sampidevkit/ACIM-PowerSupply/V0/Production/Picture/Top.png

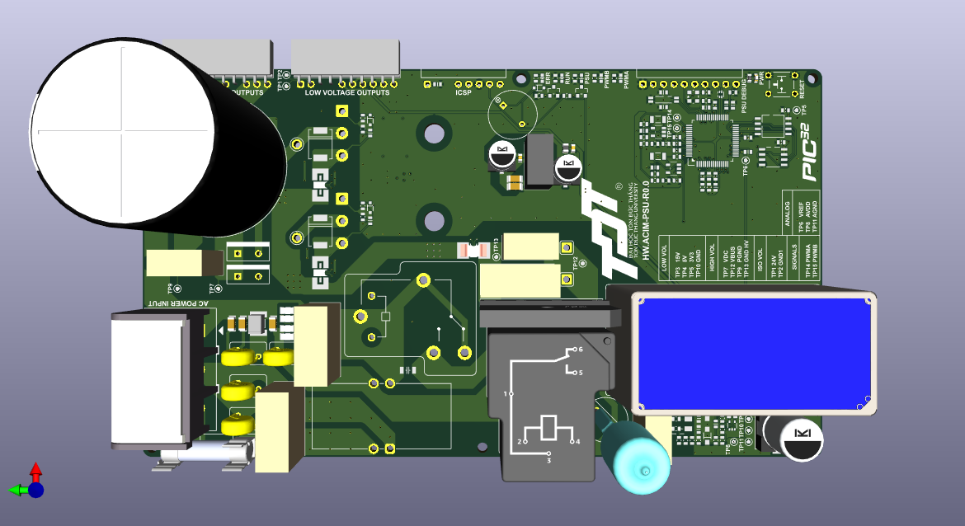
V0/Production/Picture/Top.png
