sampidevkit/ACIM-PowerSupply/Readme.md

# AC INDUCTION MOTOR - POWER SUPPLY BOARD
