sampidevkit/ACIM-PowerSupply/V0/Docs/Ferrite Toroid Coil 1200uH.pdf

– 4 - 5/23/24 9:33 AM
Coil64 v2.2.31 - Ferrite toroid coil

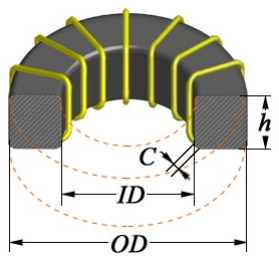
[picture p2: figure]

Input:
Inductance L: 1,200 microH Outside diameter OD: 31.5 mm Inside diameter ID: 18.8 mm Core height h: 13.3 mm
Wire diameter d: 1.5 mm
Magnetic permeability μ: 6,200 Chamfer C: 2 mm

Result:
Number of turns of the coil N = 11.996
Length of wire without leads lw = 47.144 cm
AL = 8,339 nH/N² Effective magnetic path length (le): 75.609 mm

Effective area of magnetic path (Ae): 80.926 mm² Effective volume (Ve): 6,118.72 mm³

1
