sampidevkit/ACIM-PowerSupply/V0/Docs/Ferrite Toroid Coil 900uH.pdf

1 - 12/19/23 10:08 PM

## Coil64 v2.1.29 - Ferrite toroid coil


Input:
Inductance L: 900 microH
Outside diameter OD: 31 mm Inside diameter ID: 19 mm
Core height h: 13 mm
Wire diameter d: 1 mm
Init magnetic permeability μ: 1,000 Chamfer C: 0 mm

Result:
Number of turns of the coil N = 26.591 Length of wire without leads lw = 1.01 m AL = 1,273 nH/N²

1
