sampidevkit/ACIM-PowerSupply/V0/Docs/WireDiaCalc.png

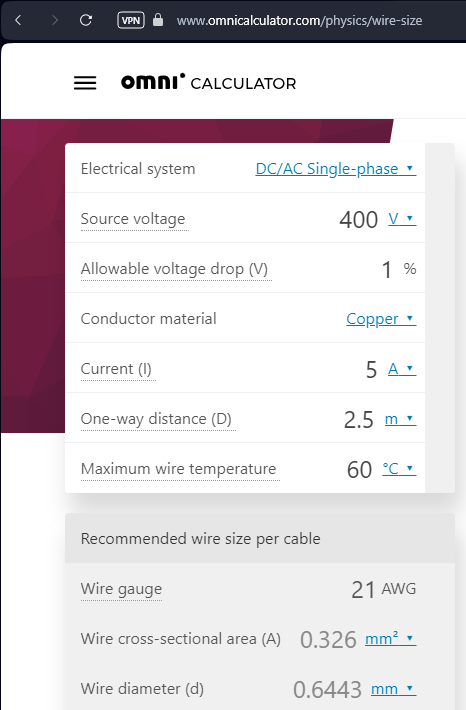
V0/Docs/WireDiaCalc.png
