sampidevkit/ACIM-PowerSupply/V0/Production/Picture/Bot 2.png

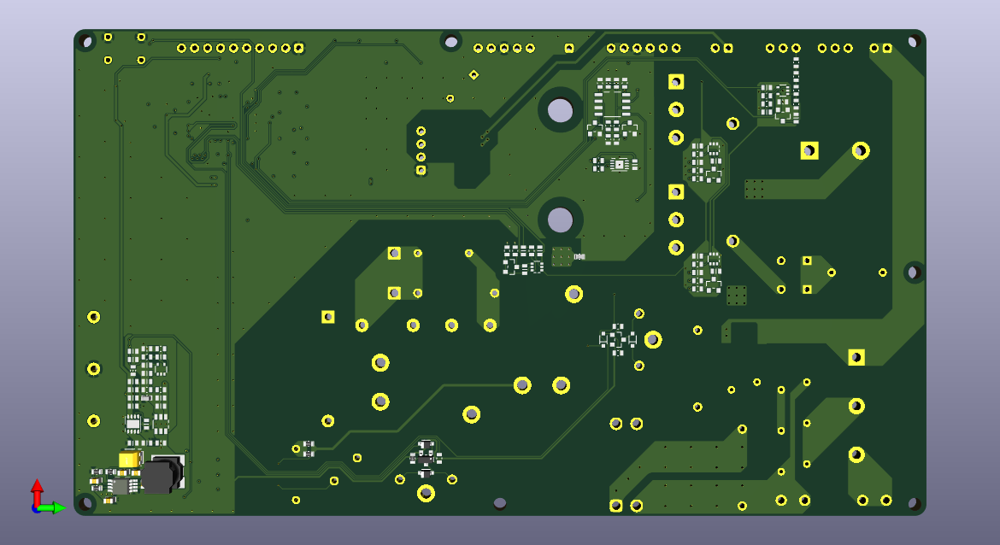
V0/Production/Picture/Bot 2.png
