sampidevkit/ACIM-PowerSupply/V0/Production/Picture/Top 2.png

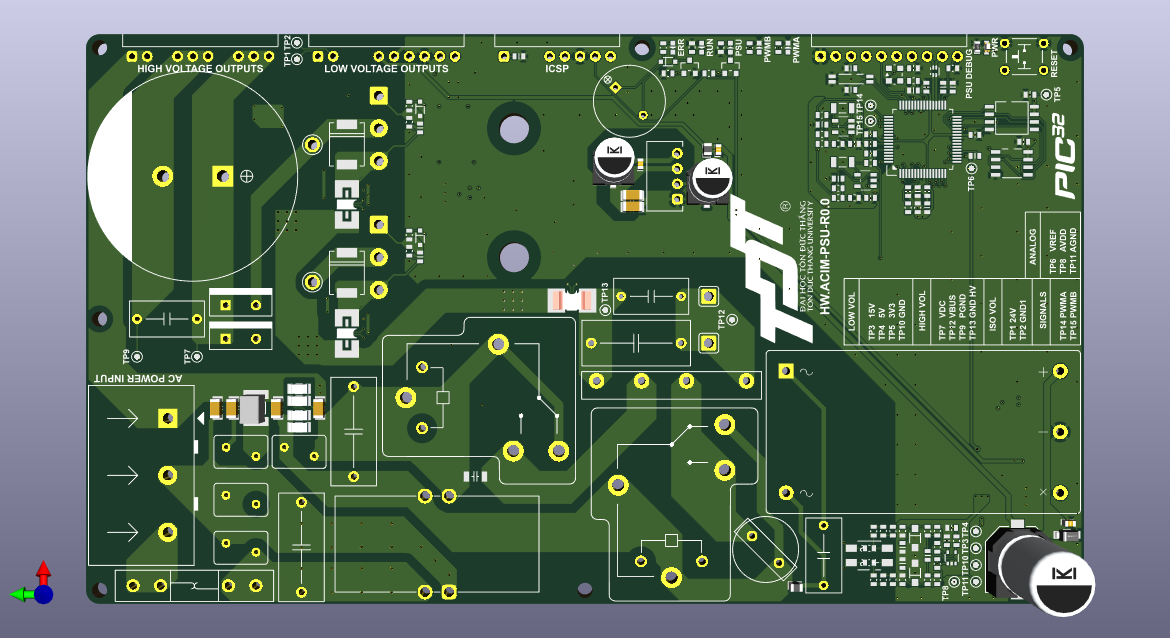
V0/Production/Picture/Top 2.png
