sampidevkit/ACIM-PowerSupply/V0/Production/BoM/HW.ACIM-PSU.xlsx

# | MNP | MFT | Description | Reference | Qty
35 | YK4410303000G | Amphenol | CONN BARRIER STRIP 3CIRC 0.374" | J1 | 1
25 | MMBD4148SE | ANBON | DIODE ARRAY GP 75V 150MA SOT23 | D12,D13,D16,D17 | 4
40 | MOV-07D471KTR | Bourns | VARISTOR 470V 1.2KA DISC 7MM | M1,M2,M3,M4 | 4
17 | ESMQ451VSN681MA50S | Chemi-Con | CAP ALUM 680UF 20% 450V SNAP | C44 | 1
4 | TS02-66-170-BK-160-SCR-D | CUI | SWITCH TACTILE 6x6x17MM SPST-NO 0.05A 12V | BT1 | 1
43 | DMN2310U-7 | Diodes | MOSFET N-CH 20 V 1.6A SOT-23-3 | Q1,Q2,Q4,Q5,Q8 | 5
64 | ZXCT199QA1DW-7 | Diodes | CM VOLTAGE OUTPUT SOT363 T&R 3K | U7,U8,U10 | 3
65 | AP331AWG-7 | Diodes | IC COMPARATOR 1 GEN PUR SOT25 | U12,U13 | 2
23 | S5M | Diotec | DIODE GEN PURP 1KV 5A SMC | D7,D10 | 2
38 | MCL2012V1-4R7-R | Eaton | FIXED IND 4.7UH 120MA 400MOHM SM | L1,L2 | 2
50 | MSMA2512R0050FGM | Eaton | RES 0.005 OHM 1% 3W 2512 | R15,R28 | 2
51 | MSMA2512R0100FGN | Eaton | RES 0.01 OHM 1% 3W 2512 | R19 | 1
21 | F4TVS16A | Good-Ark | TVS, UNI-DIR, 400W, 16V, ESGA | D1 | 1
27 | B19Y1NB--20C000113U1930 | Harvatek | LED BLUE CLEAR 0603 SMD | D18,D24 | 2
28 | B1911USD-20D000114U1930 | Harvatek | LED RED DIFFUSED 0603 SMD | D20 | 1
29 | B1911NG--20D000214U1930 | Harvatek | LED GREEN DIFFUSED 0603 SMD | D21 | 1
30 | B1931TW--20P000314U1930 | Harvatek | LED WHITE 0603 SMD | D22,D23 | 2
33 | MCM1012B121F06BPDG | INPAQ | CMF 1210 120OHM 300MA 2LN SMD | FT5 | 1
13 | TLJB227M006R0500 | KAVX | CAP TANT 220UF 20% 6.3V 1411 | C19 | 1
10 | A768MS477M1ELAE017 | KEMET | CAP ALUM POLY 470UF 20% 25V SMD | C6 | 1
12 | A768EB476M1VLAE042 | KEMET | CAP ALUM POLY 47UF 20% 35V SMD | C10,C18 | 2
31 | 01000056Z | Littelfuse | FUSE CLIP CARTRIDGE 250V 10A PCB | F1 | 1
22 | 1N4148WX-TP | MCC | DIODE GEN PURP 75V 150MA SOD323 | D2,D3,D4,D5,D6,D9,D19 | 7
26 | BZT52C3V0-TP | MCC | DIODE ZENER 3V 200MW SOD123 | D14,D15 | 2
24 | APT15DQ60KG | Microchip | DIODE GP 600V 15A TO220 | D8,D11 | 2
58 | MCP16311-E/MS | Microchip | IC REG BUCK ADJ 1A 8MSOP | U1 | 1
59 | MCP1727-3302E/MF | Microchip | IC REG LINEAR 3.3V 1.5A 8DFN | U2 | 1
60 | MCP1501T-33E/CHY | Microchip | IC VREF SERIES 0.1% SOT23-6 | U3 | 1
61 | AT30TS74-MA8M-T | Microchip | SENSOR DIGITAL -55C-125C 8UDFN | U4 | 1
62 | MCP14E4T-E/SN | Microchip | IC GATE DRVR LOW-SIDE 8SOIC | U5 | 1
66 | PIC32MK1024MCM064-I/PT | Microchip | IC MCU 32BIT 1MB FLASH 64TQFP | U14 | 1
69 | DSC1001CE1-012.0000 | Microchip | MEMS OSC XO 12.0000MHZ CMOS SMD | U17 | 1
41 | LD10-23B15R2-RC | Mornsun | ENCLOSED AC DC CONVERTER 10W 1 O | MD1 | 1
42 | B1524S-1WR3 | Mornsun | DC DC CONVERTER 24V 1W | MD2 | 1
63 | NCV21871SQ3T2G | Onsemi | IC OPAMP GP 1 CIRCUIT SC88A | U6,U9,U11 | 3
7 | ECW-FE2W105K | Panasonic | CAP FILM 1UF 10% 450VDC RADIAL | C2,C11,C35 | 3
5 | AT-1224-TWT-5V-2-R | PUI | BUZZER MAGNETIC 5V 12MM TH | BZ1 | 1
32 | PE-0603PFB121ST | Pulse | FERRITE BEAD 120 OHM 1A 0603 1LN | FT2,FT3,FT4,FT6 | 4
9 | CL10B104KB8NNNC | Samsung | CAP CER 0.1UF 50V X7R 0603 | C4,C9,C13,C16,C17,C20,C23,C24,C25,C26,C37,C38,C41,C46,C49,C50,C51,C59,C62,C64,C65,C66,C67,C68,C69,C71,C76,C77,C78,C79,C80,C82,C83,C90 | 34
11 | CL10A106MQ8NNNC | Samsung | CAP CER 10UF 6.3V X5R 0603 | C8,C27,C29,C34,C42,C85 | 6
15 | CL10B332KB8NNNC | Samsung | CAP CER 3.3nF 50V X7R 0603 | C30,C32,C53,C54 | 4
16 | CL10B102KB8NNNC | Samsung | CAP CER 1nF 50V X7R 0603 | C36,C40,C47,C48,C52,C57,C58,C60,C61,C63,C70,C72,C73 | 13
18 | CL10A105KA8NNNC | Samsung | CAP CER 1UF 25V X5R 0603 | C55 | 1
19 | CL10B103KB8NNNC | Samsung | CAP CER 10nF 50V X7R 0603 | C56 | 1
2 | GBJ2510 | SMC | BRIDGE RECT 1PHASE 1KV 25A GBJ | BR1 | 1
3 | MB10F | SMC | BRIDGE RECT 1PHASE 1KV 500MA MBF | BR2 | 1
57 | SLA-5VDC-SL-C | Songle | 5V 30A SPDT (1 Form C) 6 Plugin,27.6x32mm Power Relays ROHS | RL1,RL2 | 2
44 | STGWT40HP65FB | ST | TRENCH GATE FIELD-STOP IGBT, HB | Q3,Q6 | 2
67 | M95256-WMN6P | ST | IC EEPROM 256KBIT SPI 8SOIC | U15 | 1
36 | PPTC101LGBN-RC | Sullins | CONN HDR 10POS 0.1 TIN PCB R/A | J2,J4,J5 | 3
37 | PBC08SBAN | Sullins | CONN HEADER R/A 8POS 2.54MM | J3 | 1
39 | HPC 6045NV-220M | TAI-TECH | FIXED IND 22UH 1.9A 0.096OHM SMD | L3 | 1
6 | BFC233824104 | VISHAY | CAP FILM 0.1UF 20% 560VDC RADIAL | C1,C28,C43 | 3
45 | SI2301CDS-T1-GE3 | Vishay | MOSFET P-CH 20V 3.1A SOT23-3 | Q7 | 1
14 | 0603N220J500CT | Walsin | CAP CER 22PF 50V C0G/NP0 0603 | C22,C31,C33,C45,C75,C81,C84,C86,C87 | 9
48 | WR12X105 JTL | Walsin | RES 1M OHM 5% 1/4W 1206 | R4,R7,R8,R9,R69,R70 | 6
8 | 885342208022 | WE | CAP CER 100PF 2000V X7R 1206 | C3,C5,C7,C12,C14,C15,C21 | 7
68 | W25Q128FVSG | Winbond | IC FLASH 128MBIT SPI/QUAD 8SOIC | U16 | 1
20 | CC0603BRNPO9BN9R0 | YAGEO | CAP CER 9PF 50V C0G/NPO 0603 | C88,C89 | 2
34 | 4532-301-LF | YAGEO | GDT SMD 4532, 300V30% 2KA, REEL | G1 | 1
46 | RC0603FR-0710RL | YAGEO | RES 10 OHM 1% 1/10W 0603 | R1,R2,R17,R25,R33,R34,R35,R36,R45,R47,R48,R55,R56,R57,R58,R71,R72,R73 | 18
47 | RC0603FR-07100KL | YAGEO | RES 100K OHM 1% 1/10W 0603 | R3,R5,R11,R13,R20,R22,R29,R30,R37,R38,R39,R40,R41,R42,R61,R62,R63,R64,R65,R75,R79,R82 | 22
49 | RC0603FR-0710KL | YAGEO | RES 10K OHM 1% 1/10W 0603 | R6,R10,R12,R14,R16,R18,R24,R26,R27,R59,R76 | 11
52 | AC0603FR-071K1L | YAGEO | RES SMD 1.1K OHM 1% 1/10W 0603 | R21,R23,R43,R44,R46,R49,R50,R66,R67,R68,R74,R77,R78,R80,R81,R84,R85 | 17
53 | RC0603FR-0739K2L | YAGEO | RES 39.2K OHM 1% 1/10W 0603 | R51,R52 | 2
54 | RC0603FR-1340K2L | YAGEO | RES 40.2K OHM 1% 1/10W 0603 | R53,R54 | 2
55 | RC0603FR-13470KL | YAGEO | RES 470K OHM 1% 1/10W 0603 | R60 | 1
56 | RC0603JR-070RL | YAGEO | RES 0 OHM JUMPER 1/10W 0603 | R83 | 1
70 | 32.768K12.5PI/6914E | YIC | CRYSTAL 32.7680KHZ 12.5PF SMD | X1 | 1
1 | 1609954437_VNAMZ-6936739394 |  | HALOGEN LAMP 220V/50W | B1 | 1
