sampidevkit/ACIM-PowerSupply/V0/Production/Schematic/HW.ACIM-PSU.pdf

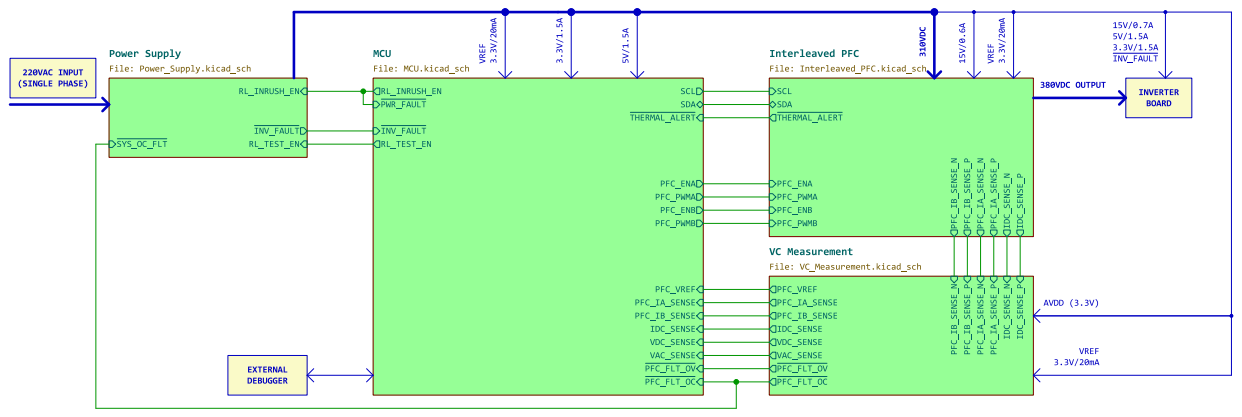
[picture p6: page 1]

Schematic Designed by ... PCB Designed by ... Approved by ...

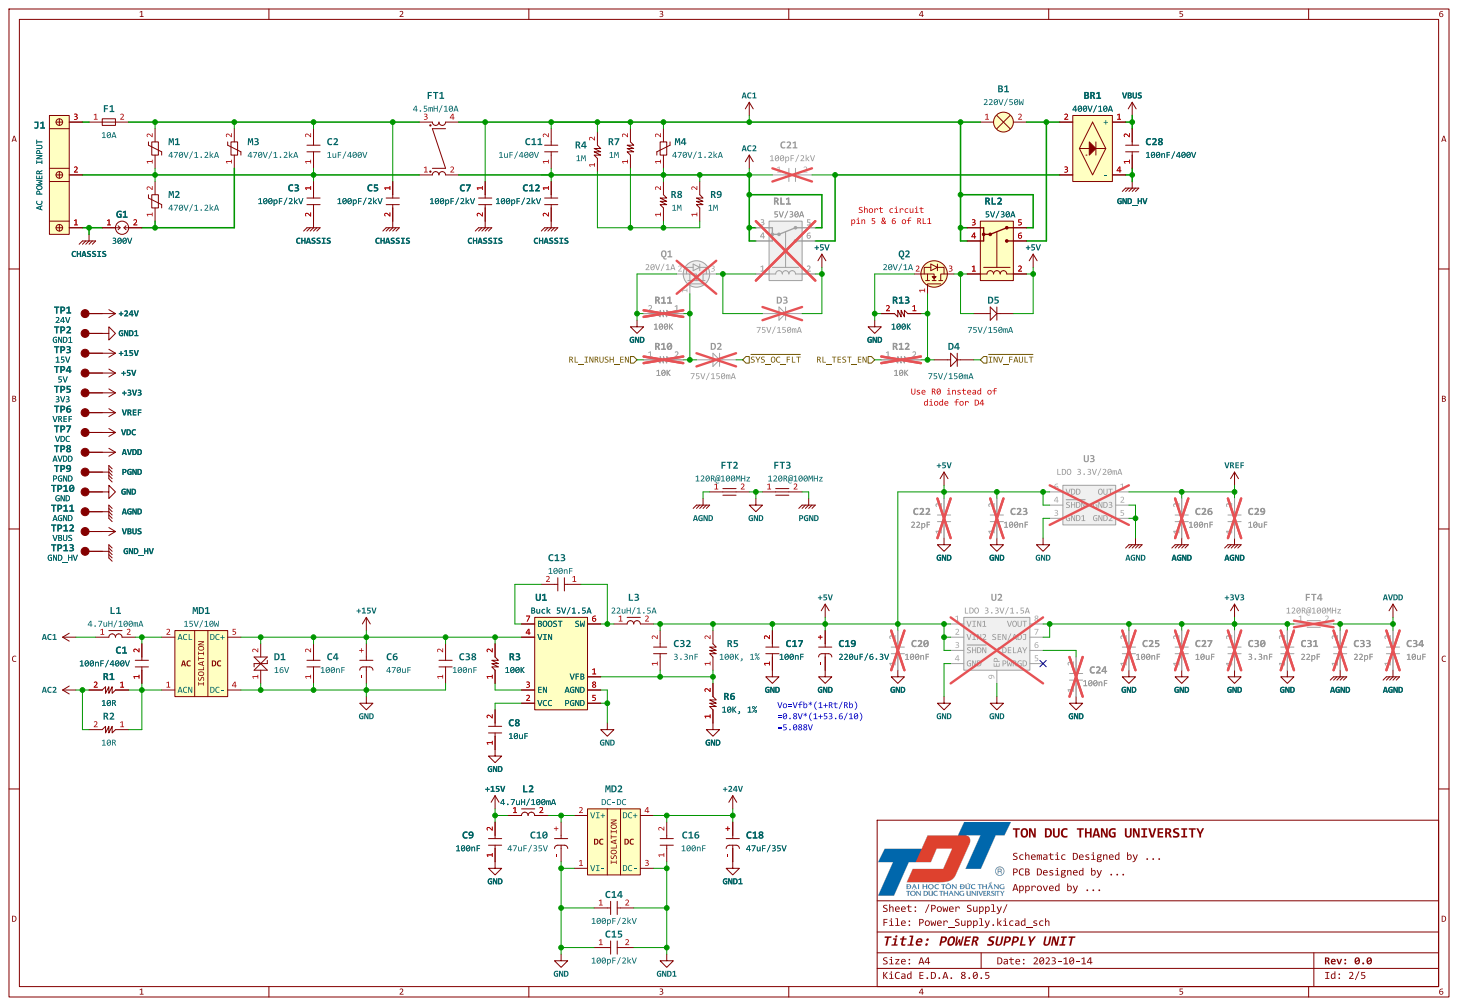
[picture p7: page 2]

Schematic Designed by ... PCB Designed by ... Approved by ... GND

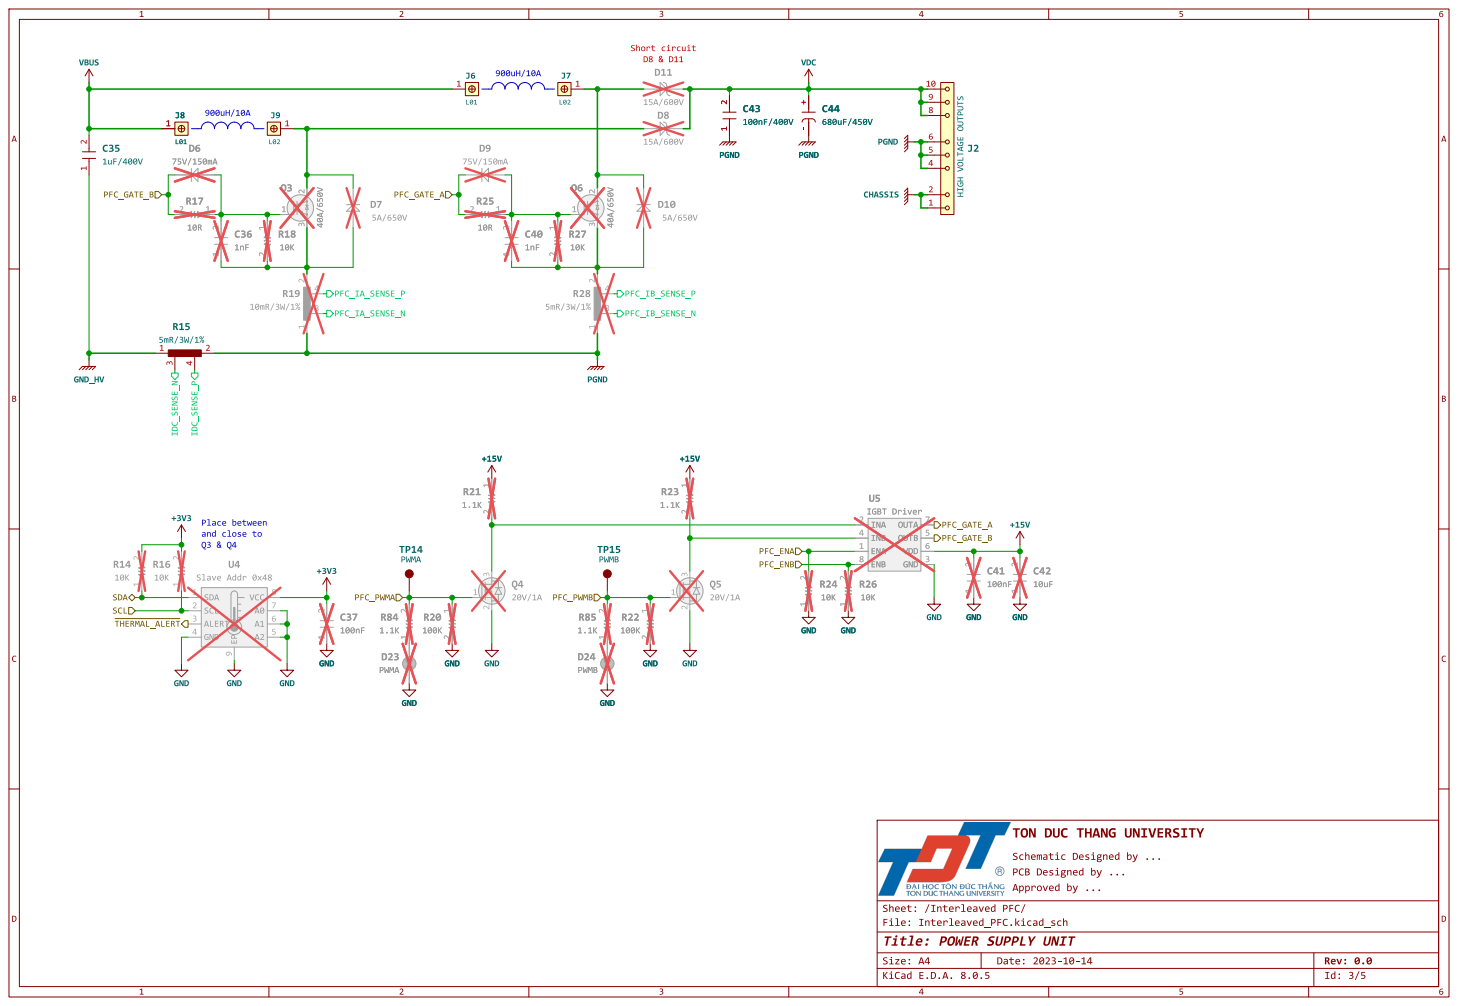
[picture p8: page 3]

1 2 GND GND D24 PWMB GND GNDR20

Schematic Designed by ... PCB Designed by ... Approved by ... D23 PWMA

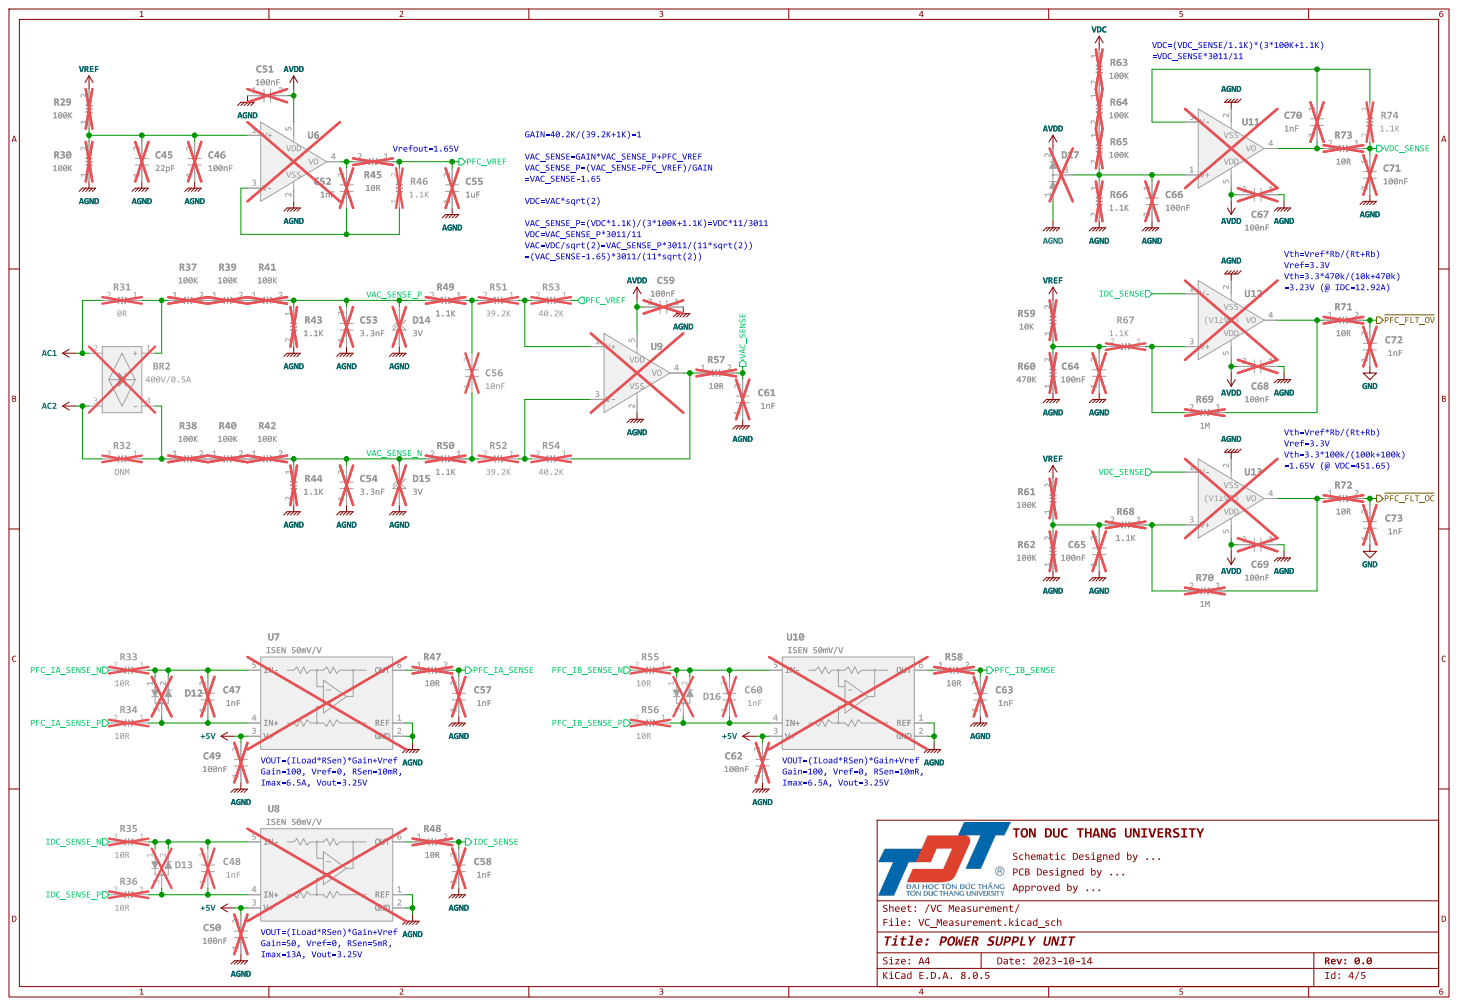
[picture p9: page 4]

VAC_SENSE_P=(VDC*1.1K)/(3*100K+1.1K)=VDC*11/3011 VDC=VAC_SENSE_P*3011/11 VAC=VDC/sqrt(2)=VAC_SENSE_P*3011/(11*sqrt(2))

Vth=Vref*Rb/(Rt+Rb) Vref=3.3V

Schematic Designed by ... PCB Designed by ... Approved by ... AGND

VOUT=(ILoad*RSen)*Gain+Vref Gain=100, Vref=0, RSen=10mR,

VOUT=(ILoad*RSen)*Gain+Vref Gain=50, Vref=0, RSen=5mR,

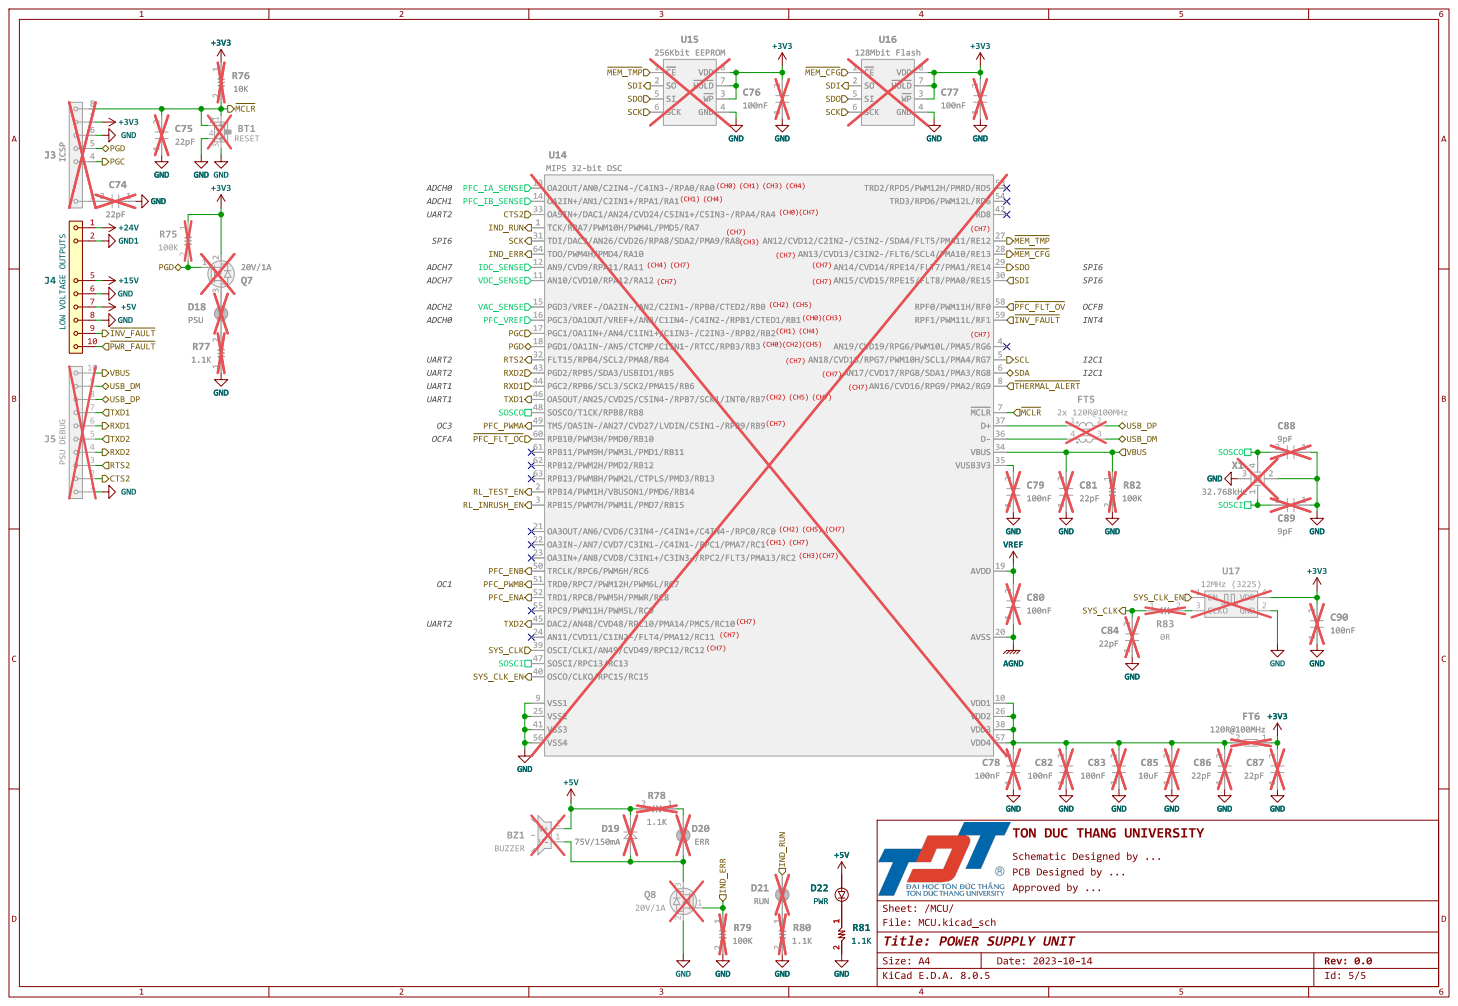
[picture p10: page 5]

Schematic Designed by ... PCB Designed by ... Approved by ...
