sampidevkit/ACIM-PowerSupply/V0/Design/HW.ACIM-PSU/Interleaved_PFC.kicad_sch

## KiCad design V0/Design/HW.ACIM-PSU/Interleaved_PFC.kicad_sch (2024-10-10)

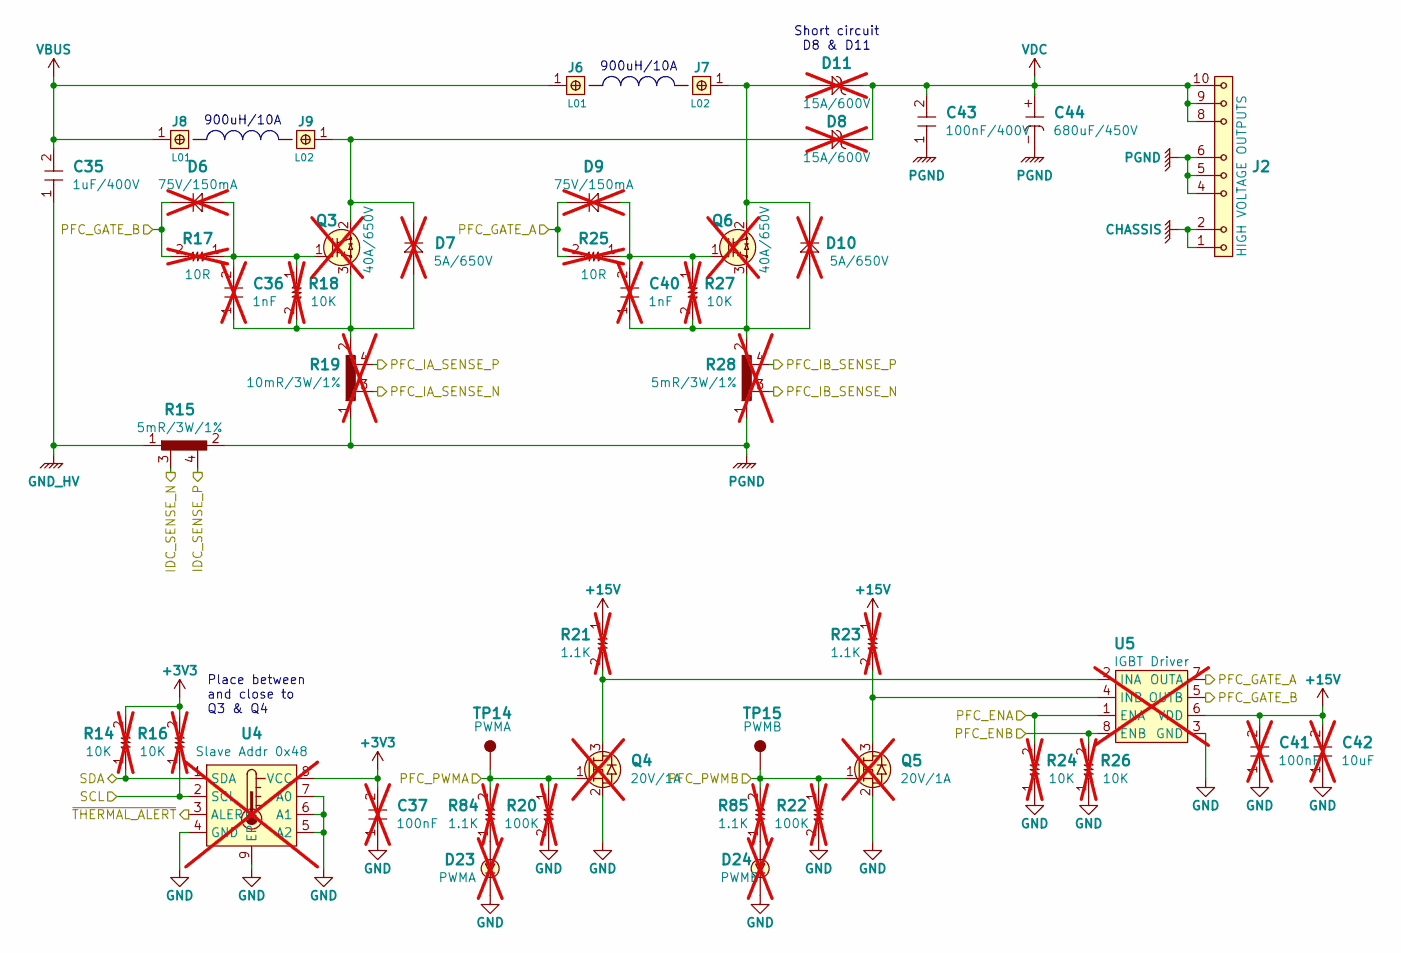
[picture p11: schematic Interleaved_PFC.kicad_sch]

Parts:
C35: 1uF/400V; ECWFE2W105
C36, C40: 1nF; CAP0603; not fitted
C37, C41: 100nF; CAP0603; not fitted
C42: 10uF; CAP0603; not fitted
C43: 100nF/400V; CAP_FILM_6.0x12.0x12.5-P10
C44: 680uF/450V; ESMQ451VSN681MA50S
D6, D9: 75V/150mA; SOD-323; not fitted
D7, D10: 5A/650V; DO-214AB; not fitted
D8, D11: 15A/600V; TO-220; not fitted
D23: PWMA; LED0603; not fitted
D24: PWMB; LED0603; not fitted
J2: HIGH VOLTAGE OUTPUTS; HDF1x10x2.54_TH_RA
J6, J8: L01; PAD01-2516
J7, J9: L02; PAD01-2516
Q3, Q6: 40A/650V; TO-218AC-HF; not fitted
Q4, Q5: 20V/1A; SOT23; not fitted
R14, R16, R18, R24, R26, R27: 10K; RES0603; not fitted
R15: 5mR/3W/1%; SHU2512
R17, R25: 10R; RES0603; not fitted
R19: 10mR/3W/1%; SHU2512; not fitted
R20, R22: 100K; RES0603; not fitted
R21, R23, R84, R85: 1.1K; RES0603; not fitted
R28: 5mR/3W/1%; SHU2512; not fitted
TP14: PWMA; TP1MM
TP15: PWMB; TP1MM
U4: Slave Addr 0x48; TDFN8_2x3_MCHP; not fitted
U5: IGBT Driver; SOIC8_3.9_MCHP; not fitted

Connections:
+3V3: C37.2, R14.2, R16.2, U4.8 (VCC)
+15V: C41.2, C42.2, R21.1, R23.1, U5.6 (VDD)
CHASSIS: J2.1, J2.2
GND: C37.1, C41.1, C42.1, D23.K, D24.K, Q4.2 (S), Q5.2 (S), R20.2, R22.2, R24.1, R26.1, U4.4 (GND), U4.5 (A2), U4.6 (A1), U4.7 (A0), U4.9 (EP), U5.3 (GND)
GND_HV: C35.1, R15.1
IDC_SENSE_N: R15.3
IDC_SENSE_P: R15.4
unnamed: C36.1, D7.A, Q3.3 (S), R18.2, R19.2
unnamed: C36.2, D6.A, Q3.1 (G), R17.1, R18.1
unnamed: C40.1, D10.A, Q6.3 (S), R27.2, R28.2
unnamed: C40.2, D9.A, Q6.1 (G), R25.1, R27.1
unnamed: D7.K, D8.A, J9.1, Q3.2 (D)
unnamed: D10.K, D11.A, J7.1, Q6.2 (D)
unnamed: D23.A, R84.1
unnamed: D24.A, R85.1
unnamed: Q4.3 (D), R21.2, U5.2 (INA)
unnamed: Q5.3 (D), R23.2, U5.4 (INB)
PFC_ENA: R24.2, U5.1 (ENA)
PFC_ENB: R26.2, U5.8 (ENB)
PFC_GATE_A: D9.K, R25.2, U5.7 (OUTA)
PFC_GATE_B: D6.K, R17.2, U5.5 (OUTB)
PFC_IA_SENSE_N: R19.3
PFC_IA_SENSE_P: R19.4
PFC_IB_SENSE_N: R28.3
PFC_IB_SENSE_P: R28.4
PFC_PWMA: Q4.1 (G), R20.1, R84.2, TP14.1
PFC_PWMB: Q5.1 (G), R22.1, R85.2, TP15.1
PGND: C43.1, C44.-, J2.4, J2.5, J2.6, R15.2, R19.1, R28.1
SCL: R16.1, U4.2 (SCL)
SDA: R14.1, U4.1 (SDA)
VBUS: C35.2, J6.1, J8.1
VDC: C43.2, C44.+, D8.K, D11.K, J2.8, J2.9, J2.10
~THERMAL_ALERT: U4.3 (ALERT)

Notes on the sheet:
Short circuit D8 & D11
Place between and close to Q3 & Q4
900uH/10A
