sampidevkit/ACIM-PowerSupply/V0/Design/HW.ACIM-PSU/MCU.kicad_sch

## KiCad design V0/Design/HW.ACIM-PSU/MCU.kicad_sch (2024-10-10)

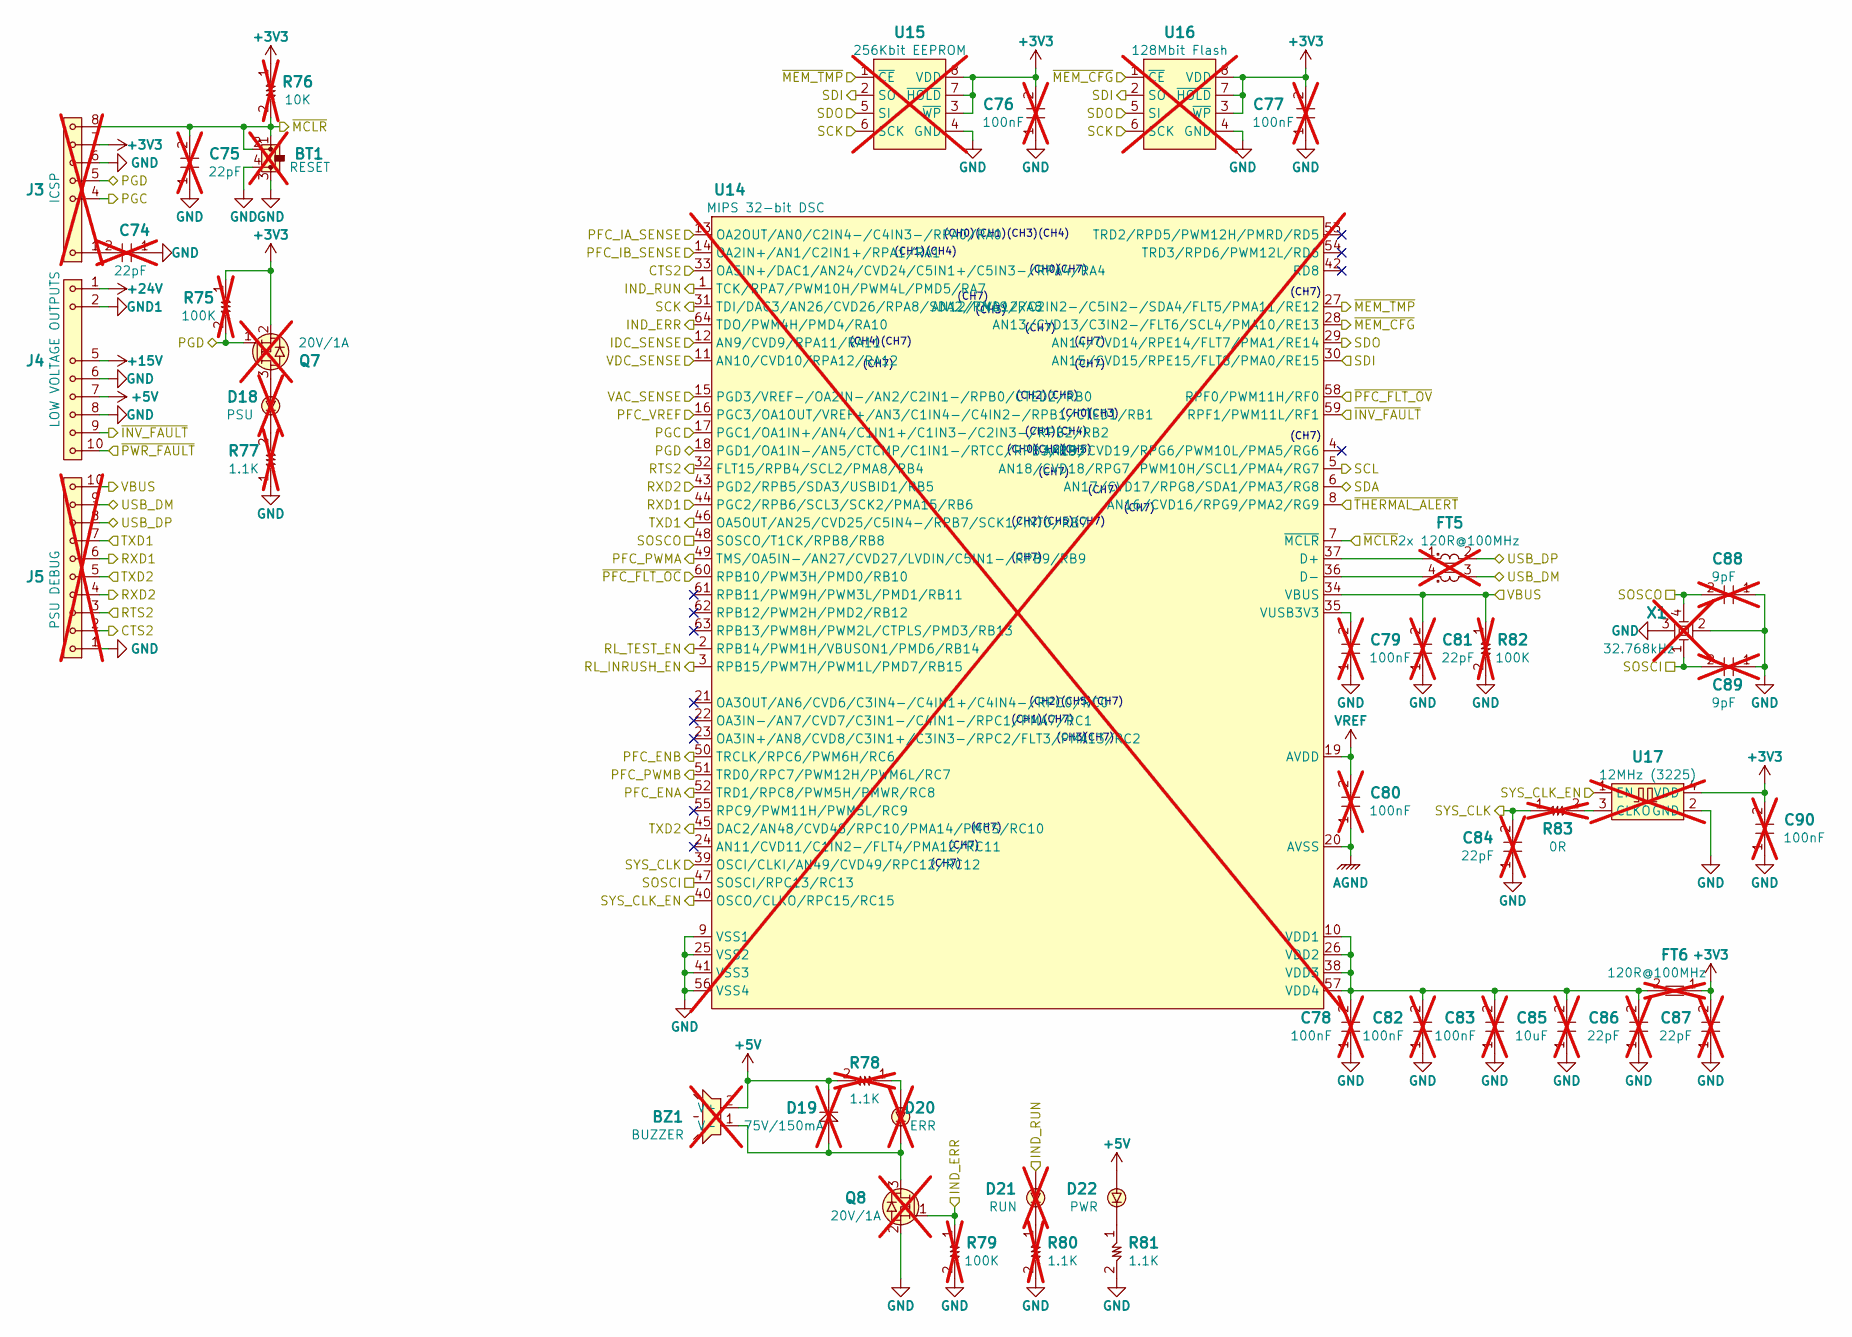
[picture p12: schematic MCU.kicad_sch]

Parts:
BT1: RESET; BUTTON_4P_6x6; not fitted
BZ1: BUZZER; AT-1224; not fitted
C74, C75, C81, C84, C86, C87: 22pF; CAP0603; not fitted
C76, C77, C78, C79, C80, C82, C83, C90: 100nF; CAP0603; not fitted
C85: 10uF; CAP0603; not fitted
C88, C89: 9pF; CAP0603; not fitted
D18: PSU; LED0603; not fitted
D19: 75V/150mA; SOD-323; not fitted
D20: ERR; LED0603; not fitted
D21: RUN; LED0603; not fitted
D22: PWR; LED0603
FT5: 2x 120R@100MHz; IND1210_4P; not fitted
FT6: 120R@100MHz; FT0603; not fitted
J3: ICSP; HDM1x8x2.54_TH_RA; not fitted
J4: LOW VOLTAGE OUTPUTS; HDF1x10x2.54_TH_RA
J5: PSU DEBUG; HDM1x10x2.54_TH_RA; not fitted
Q7, Q8: 20V/1A; SOT23; not fitted
R75, R79, R82: 100K; RES0603; not fitted
R76: 10K; RES0603; not fitted
R77, R78, R80: 1.1K; RES0603; not fitted
R81: 1.1K; RES0603
R83: 0R; RES0603; not fitted
U14: MIPS 32-bit DSC; TQFP64_10x10_MCHP; not fitted
U15: 256Kbit EEPROM; SOIC8_3.9_MCHP; not fitted
U16: 128Mbit Flash; SO8W_5.3; not fitted
U17: 12MHz (3225); CDFN3225-4LD-PL-1; not fitted
X1: 32.768kHz; SMD4-7015; not fitted

Connections:
+3V3: C76.2, C77.2, C87.2, C90.2, FT6.1, J3.7, Q7.2 (S), R75.1, R76.1, U15.3 (~WP), U15.7 (~HOLD), U15.8 (VDD), U16.3 (~WP), U16.7 (~HOLD), U16.8 (VDD), U17.4 (VDD)
+5V: BZ1.2 (V+), D19.K, D22.A, J4.7, R78.2
+15V: J4.5
+24V: J4.1
AGND: C80.1, U14.20 (AVSS)
CTS2: J5.2, U14.33 (OA5IN+/DAC1/AN24/CVD24/C5IN1+/C5IN3-/RP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)
GND: BT1.3, BT1.4, C74.1, C75.1, C76.1, C77.1, C78.1, C79.1, C81.1, C82.1, C83.1, C84.1, C85.1, C86.1, C87.1, C88.1, C89.1, C90.1, J3.6, J4.6, J4.8, J5.1, Q8.2 (S), R77.1, R79.2, R80.2, R81.2, R82.2, U14.9 (VSS1), U14.25 (VSS2), U14.41 (VSS3), U14.56 (VSS4), U15.4 (GND), U16.4 (GND), U17.2 (GND), X1.2 (GND1), X1.3 (GND2)
GND1: J4.2
IDC_SENSE: U14.12 (AN9/CVD9/RPA11/RA11)
IND_ERR: Q8.1 (G), R79.1, U14.64 (TDO/PWM4H/PMD4/RA10)
IND_RUN: D21.A, U14.1 (TCK/RPA7/PWM10H/PWM4L/PMD5/RA7)
unnamed: BZ1.1 (V-), D19.A, D20.K, Q8.3 (D)
unnamed: C74.2, J3.1
unnamed: C78.2, C82.2, C83.2, C85.2, C86.2, FT6.2, U14.10 (VDD1), U14.26 (VDD2), U14.38 (VDD3), U14.57 (VDD4)
unnamed: C79.2, U14.35 (VUSB3V3)
unnamed: D18.A, Q7.3 (D)
unnamed: D18.K, R77.2
unnamed: D20.A, R78.1
unnamed: D21.K, R80.1
unnamed: D22.K, R81.1
unnamed: FT5.1, U14.37 (D+)
unnamed: FT5.4, U14.36 (D-)
unnamed: R83.2, U17.3 (CLKO)
PFC_ENA: U14.52 (TRD1/RPC8/PWM5H/PMWR/RC8)
PFC_ENB: U14.50 (TRCLK/RPC6/PWM6H/RC6)
PFC_IA_SENSE: U14.13 (OA2OUT/AN0/C2IN4-/C4IN3-/RPA0/RA0)
PFC_IB_SENSE: U14.14 (OA2IN+/AN1/C2IN1+/RPA1/RA1)
PFC_PWMA: U14.49 (TMS/OA5IN-/AN27/CVD27/LVDIN/C5IN1-/RPB9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)
PFC_PWMB: U14.51 (TRD0/RPC7/PWM12H/PWM6L/RC7)
PFC_VREF: U14.16 (PGC3/OA1OUT/VREF+/AN3/C1IN4-/C4IN2-/RPB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)
PGC: J3.4, U14.17 (PGC1/OA1IN+/AN4/C1IN1+/C1IN3-/C2IN3-/RP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)
PGD: J3.5, Q7.1 (G), R75.2, U14.18 (PGD1/OA1IN-/AN5/CTCMP/C1IN1-/RTCC/RPB3/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)
RL_INRUSH_EN: U14.3 (RPB15/PWM7H/PWM1L/PMD7/RB15)
RL_TEST_EN: U14.2 (RPB14/PWM1H/VBUSON1/PMD6/RB14)
RTS2: J5.3, U14.32 (FLT15/RPB4/SCL2/PMA8/RB4)
RXD1: J5.6, U14.44 (PGC2/RPB6/SCL3/SCK2/PMA15/RB6)
RXD2: J5.4, U14.43 (PGD2/RPB5/SDA3/USBID1/RB5)
SCK: U14.31 (TDI/DAC3/AN26/CVD26/RPA8/SDA2/PMA9/RA8), U15.6 (SCK), U16.6 (SCK)
SCL: U14.5 (AN18/CVD18/RPG7/PWM10H/SCL1/PMA4/RG7)
SDA: U14.6 (AN17/CVD17/RPG8/SDA1/PMA3/RG8)
SDI: U14.30 (AN15/CVD15/RPE15/FLT8/PMA0/RE15), U15.2 (SO), U16.2 (SO)
SDO: U14.29 (AN14/CVD14/RPE14/FLT7/PMA1/RE14), U15.5 (SI), U16.5 (SI)
SOSCI: C89.2, U14.47 (SOSCI/RPC13/RC13), X1.1 (X1)
SOSCO: C88.2, U14.48 (SOSCO/T1CK/RPB8/RB8), X1.4 (X2)
SYS_CLK: C84.2, R83.1, U14.39 (OSCI/CLKI/AN49/CVD49/RPC12/RC12)
SYS_CLK_EN: U14.40 (OSCO/CLKO/RPC15/RC15), U17.1 (EN)
TXD1: J5.7, U14.46 (OA5OUT/AN25/CVD25/C5IN4-/RPB7/SCK1/INT0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)
TXD2: J5.5, U14.45 (DAC2/AN48/CVD48/RPC10/PMA14/PMCS/RC10)
USB_DM: FT5.3, J5.9
USB_DP: FT5.2, J5.8
VAC_SENSE: U14.15 (PGD3/VREF-/OA2IN-/AN2/C2IN1-/RPB0/CTED2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)
VBUS: C81.2, J5.10, R82.1, U14.34 (VBUS)
VDC_SENSE: U14.11 (AN10/CVD10/RPA12/RA12)
VREF: C80.2, U14.19 (AVDD)
~INV_FAULT: J4.9, U14.59 (RPF1/PWM11L/RF1)
~MCLR: BT1.1, BT1.2, C75.2, J3.8, R76.2, U14.7 (~MCLR)
~MEM_CFG: U14.28 (AN13/CVD13/C3IN2-/FLT6/SCL4/PMA10/RE13), U16.1 (~CE)
~MEM_TMP: U14.27 (AN12/CVD12/C2IN2-/C5IN2-/SDA4/FLT5/PMA1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), U15.1 (~CE)
~PFC_FLT_OC: U14.60 (RPB10/PWM3H/PMD0/RB10)
~PFC_FLT_OV: U14.58 (RPF0/PWM11H/RF0)
~PWR_FAULT: J4.10
~THERMAL_ALERT: U14.8 (AN16/CVD16/RPG9/PMA2/RG9)

Notes on the sheet:
(CH7)
(CH5)
(CH1)
(CH3)
(CH4)
(CH2)
(CH0)
