sampidevkit/ACIM-PowerSupply/V0/Design/HW.ACIM-PSU/Power_Supply.kicad_sch

## KiCad design V0/Design/HW.ACIM-PSU/Power_Supply.kicad_sch (2024-10-10)

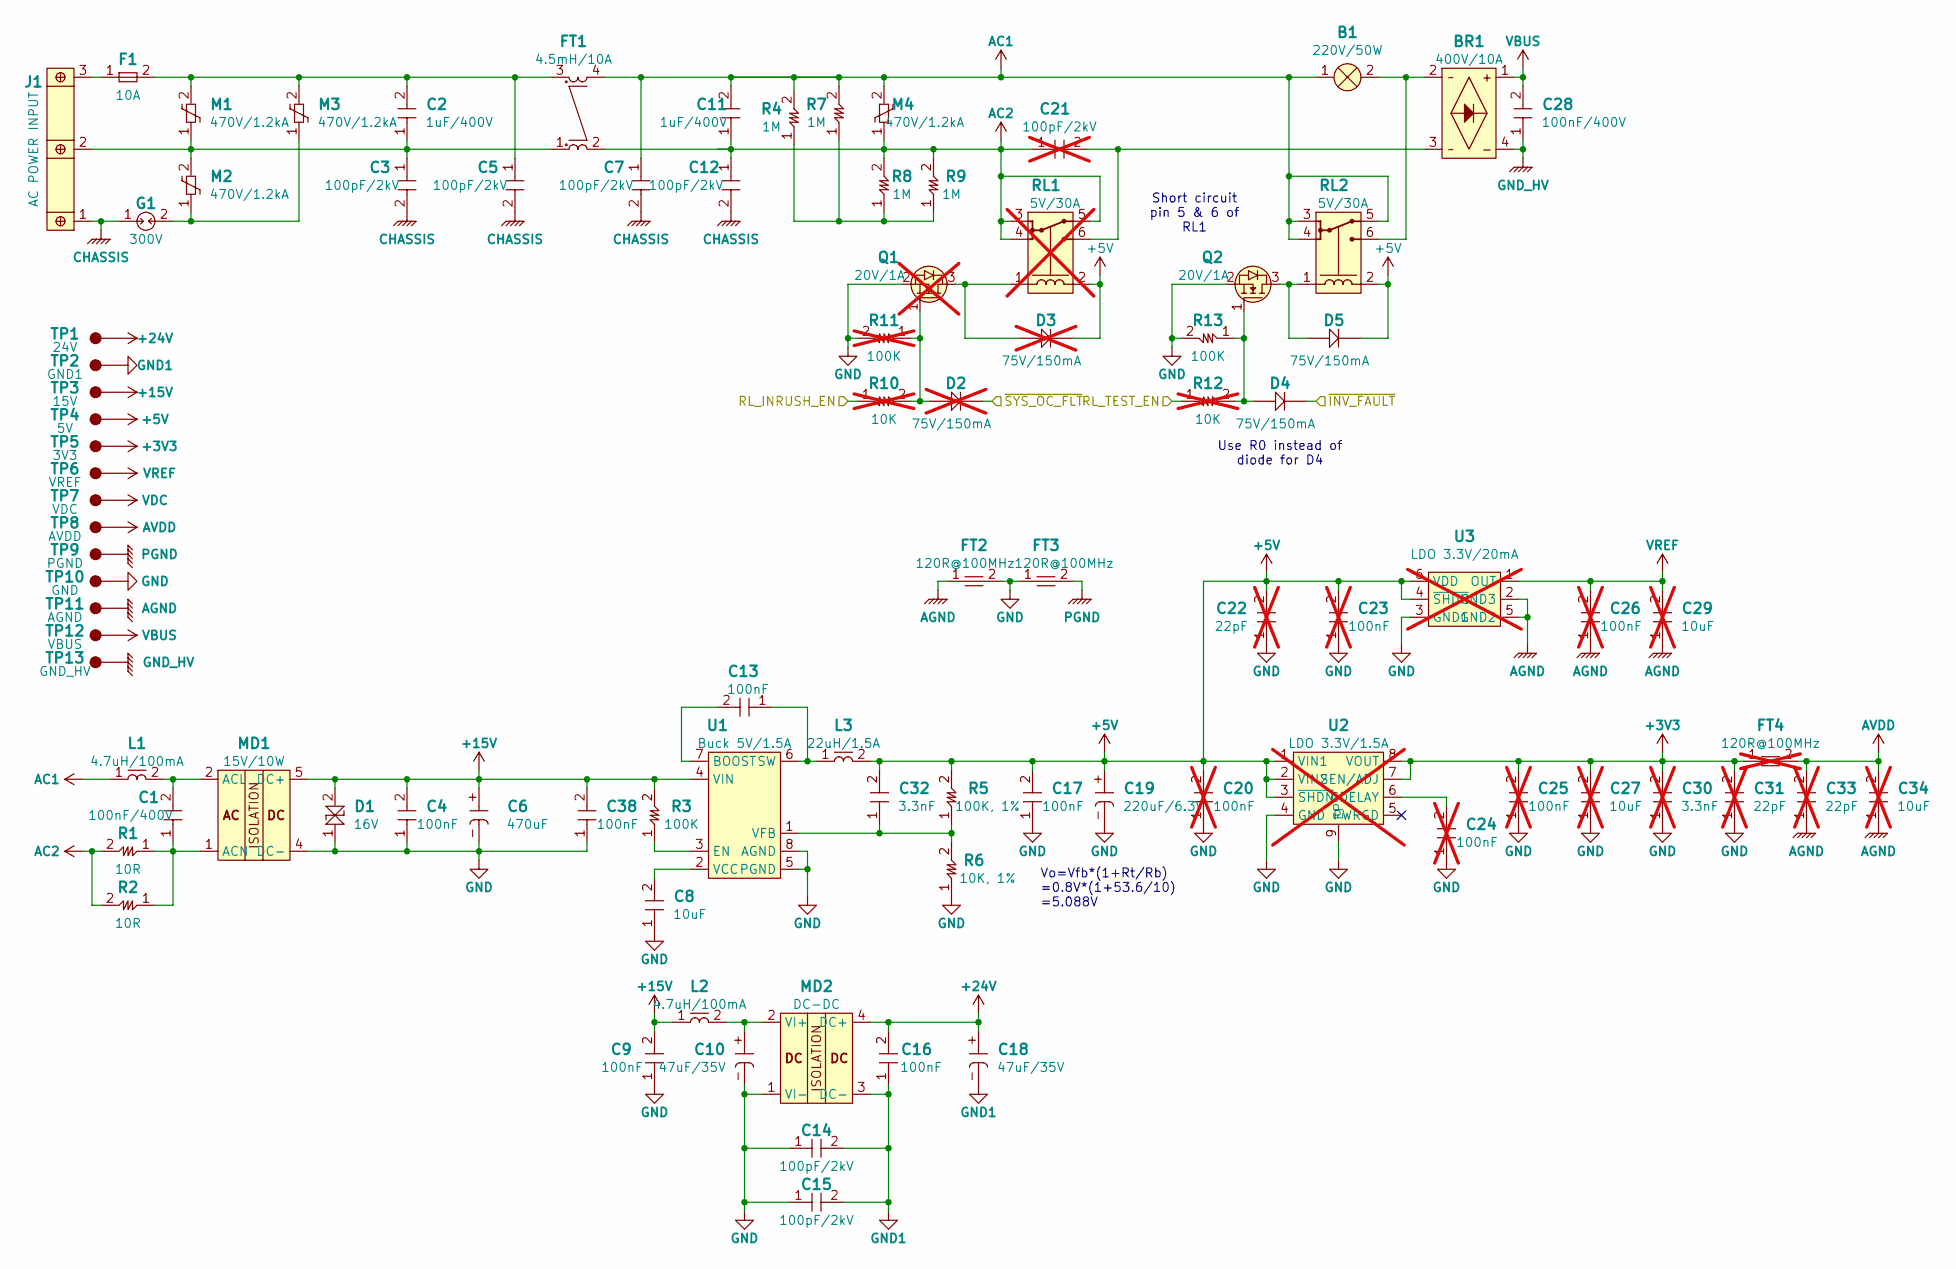
[picture p13: schematic Power_Supply.kicad_sch]

Parts:
B1: 220V/50W; LAMP_6.35MM
BR1: 400V/10A; GBJ25xx
C1, C28: 100nF/400V; CAP_FILM_6.0x12.0x12.5-P10
C2, C11: 1uF/400V; ECWFE2W105
C3, C5, C7, C12, C14, C15: 100pF/2kV; CAP1206
C4, C9, C13, C16, C17, C38: 100nF; CAP0603
C6: 470uF; CAP_ELEC-10.3x10.3-DIA10
C8: 10uF; CAP0603
C10, C18: 47uF/35V; CAP_ELEC-6.6x6.6-DIA6.3
C19: 220uF/6.3V; CAP1411
C20, C23, C24, C25, C26: 100nF; CAP0603; not fitted
C21: 100pF/2kV; CAP1206; not fitted
C22, C31, C33: 22pF; CAP0603; not fitted
C27, C29, C34: 10uF; CAP0603; not fitted
C30: 3.3nF; CAP0603; not fitted
C32: 3.3nF; CAP0603
D1: 16V; SOD-123FL_12
D2, D3: 75V/150mA; SOD-323; not fitted
D4, D5: 75V/150mA; SOD-323
F1: 10A; 01000056Z
FT1: 4.5mH/10A; ToroidCoil-3119-13-D1
FT2, FT3: 120R@100MHz; FT0603
FT4: 120R@100MHz; FT0603; not fitted
G1: 300V; GDT1812_3532
J1: AC POWER INPUT; TMB3_9.5
L1, L2: 4.7uH/100mA; IND0805
L3: 22uH/1.5A; IND6045
M1, M2, M3, M4: 470V/1.2kA; MOV5MM
MD1: 15V/10W; LD10-23BxxR2-RC
MD2: DC-DC; B1524S-1WR3
Q1: 20V/1A; SOT23; not fitted
Q2: 20V/1A; SOT23
R1, R2: 10R; RES0603
R3, R13: 100K; RES0603
R4, R7, R8, R9: 1M; RES1206
R5: 100K, 1%; RES0603
R6: 10K, 1%; RES0603
R10, R12: 10K; RES0603; not fitted
R11: 100K; RES0603; not fitted
RL1: 5V/30A; SLA-12VDC-SL-C; not fitted
RL2: 5V/30A; SLA-12VDC-SL-C
TP1: 24V; TP1MM
TP2: GND1; TP1MM
TP3: 15V; TP1MM
TP4: 5V; TP1MM
TP5: 3V3; TP1MM
TP6: VREF; TP1MM
TP7: VDC; TP1MM
TP8: AVDD; TP1MM
TP9: PGND; TP1MM
TP10: GND; TP1MM
TP11: AGND; TP1MM
TP12: VBUS; TP1MM
TP13: GND_HV; TP1MM
U1: Buck 5V/1.5A; MSOP8_MCHP
U2: LDO 3.3V/1.5A; DFN8_3x3_MCHP; not fitted
U3: LDO 3.3V/20mA; SOT-23-6_MCHP; not fitted

Connections:
+3V3: C25.2, C27.2, C30.2, C31.2, FT4.1, TP5.1, U2.7 (SEN/ADJ), U2.8 (VOUT)
+5V: C17.2, C19.+, C20.2, C22.2, C23.2, C32.2, D3.K, D5.K, L3.2, R5.2, RL1.2 (COIL2), RL2.2 (COIL2), TP4.1, U2.1 (VIN1), U2.2 (VIN2), U2.3 (~SHDN), U3.4 (~SHDN), U3.6 (VDD)
+15V: C4.2, C6.+, C9.2, C38.2, D1.2 (A2), L2.1, MD1.5 (DC+), R3.2, TP3.1, U1.4 (VIN)
+24V: C16.2, C18.+, MD2.4 (DC+), TP1.1
AC1: B1.1, C7.1, C11.2, FT1.4, L1.1, M4.2, R4.2, R7.2, RL2.3 (COM), RL2.4 (COM), RL2.5 (NC)
AC2: C11.1, C12.1, C21.1, FT1.2, M4.1, R1.2, R2.2, R8.2, R9.2, RL1.3 (COM), RL1.4 (COM), RL1.5 (NC)
AGND: C26.1, C29.1, C33.1, C34.1, FT2.1, TP11.1, U3.2 (GND3), U3.5 (GND2)
AVDD: C33.2, C34.2, FT4.2, TP8.1
CHASSIS: C3.2, C5.2, C7.2, C12.2, G1.1, J1.1
GND: C4.1, C6.-, C8.1, C9.1, C10.-, C14.1, C15.1, C17.1, C19.-, C20.1, C22.1, C23.1, C24.1, C25.1, C27.1, C30.1, C31.1, C38.1, D1.1 (A1), FT2.2, FT3.1, MD1.4 (DC-), MD2.1 (VI-), Q1.2 (S), Q2.2 (S), R6.1, R11.2, R13.2, TP10.1, U1.5 (PGND), U1.8 (AGND), U2.4 (GND), U2.9 (EP), U3.3 (GND1)
GND1: C14.2, C15.2, C16.1, C18.-, MD2.3 (DC-), TP2.1
GND_HV: BR1.4 (DC-), C28.1, TP13.1
unnamed: B1.2, BR1.2 (AC1), RL2.6 (NO)
unnamed: BR1.3 (AC2), C21.2, RL1.6 (NO)
unnamed: C1.1, MD1.1 (ACN), R1.1, R2.1
unnamed: C1.2, L1.2, MD1.2 (ACL)
unnamed: C2.1, C3.1, FT1.1, J1.2, M1.1, M2.2
unnamed: C2.2, C5.1, F1.2, FT1.3, M1.2, M3.2
unnamed: C8.2, U1.2 (VCC)
unnamed: C10.+, L2.2, MD2.2 (VI+)
unnamed: C13.1, L3.1, U1.6 (SW)
unnamed: C13.2, U1.7 (BOOST)
unnamed: C24.2, U2.6 (CDELAY)
unnamed: C32.1, R5.1, R6.2, U1.1 (VFB)
unnamed: D2.A, Q1.1 (G), R10.2, R11.1
unnamed: D3.A, Q1.3 (D), RL1.1 (COIL1)
unnamed: D4.A, Q2.1 (G), R12.2, R13.1
unnamed: D5.A, Q2.3 (D), RL2.1 (COIL1)
unnamed: F1.1, J1.3
unnamed: G1.2, M2.1, M3.1
unnamed: R3.1, U1.3 (EN)
unnamed: R4.1, R7.1, R8.1, R9.1
PGND: FT3.2, TP9.1
RL_INRUSH_EN: R10.1
RL_TEST_EN: R12.1
VBUS: BR1.1 (DC+), C28.2, TP12.1
VDC: TP7.1
VREF: C26.2, C29.2, TP6.1, U3.1 (OUT)
~INV_FAULT: D4.K
~SYS_OC_FLT: D2.K

Notes on the sheet:
Vo=Vfb*(1+Rt/Rb) =0.8V*(1+53.6/10) =5.088V
Use R0 instead of diode for D4
Short circuit pin 5 & 6 of RL1
