sampidevkit/ACIM-PowerSupply/V0/Design/HW.ACIM-PSU/VC_Measurement.kicad_sch

## KiCad design V0/Design/HW.ACIM-PSU/VC_Measurement.kicad_sch (2024-10-10)

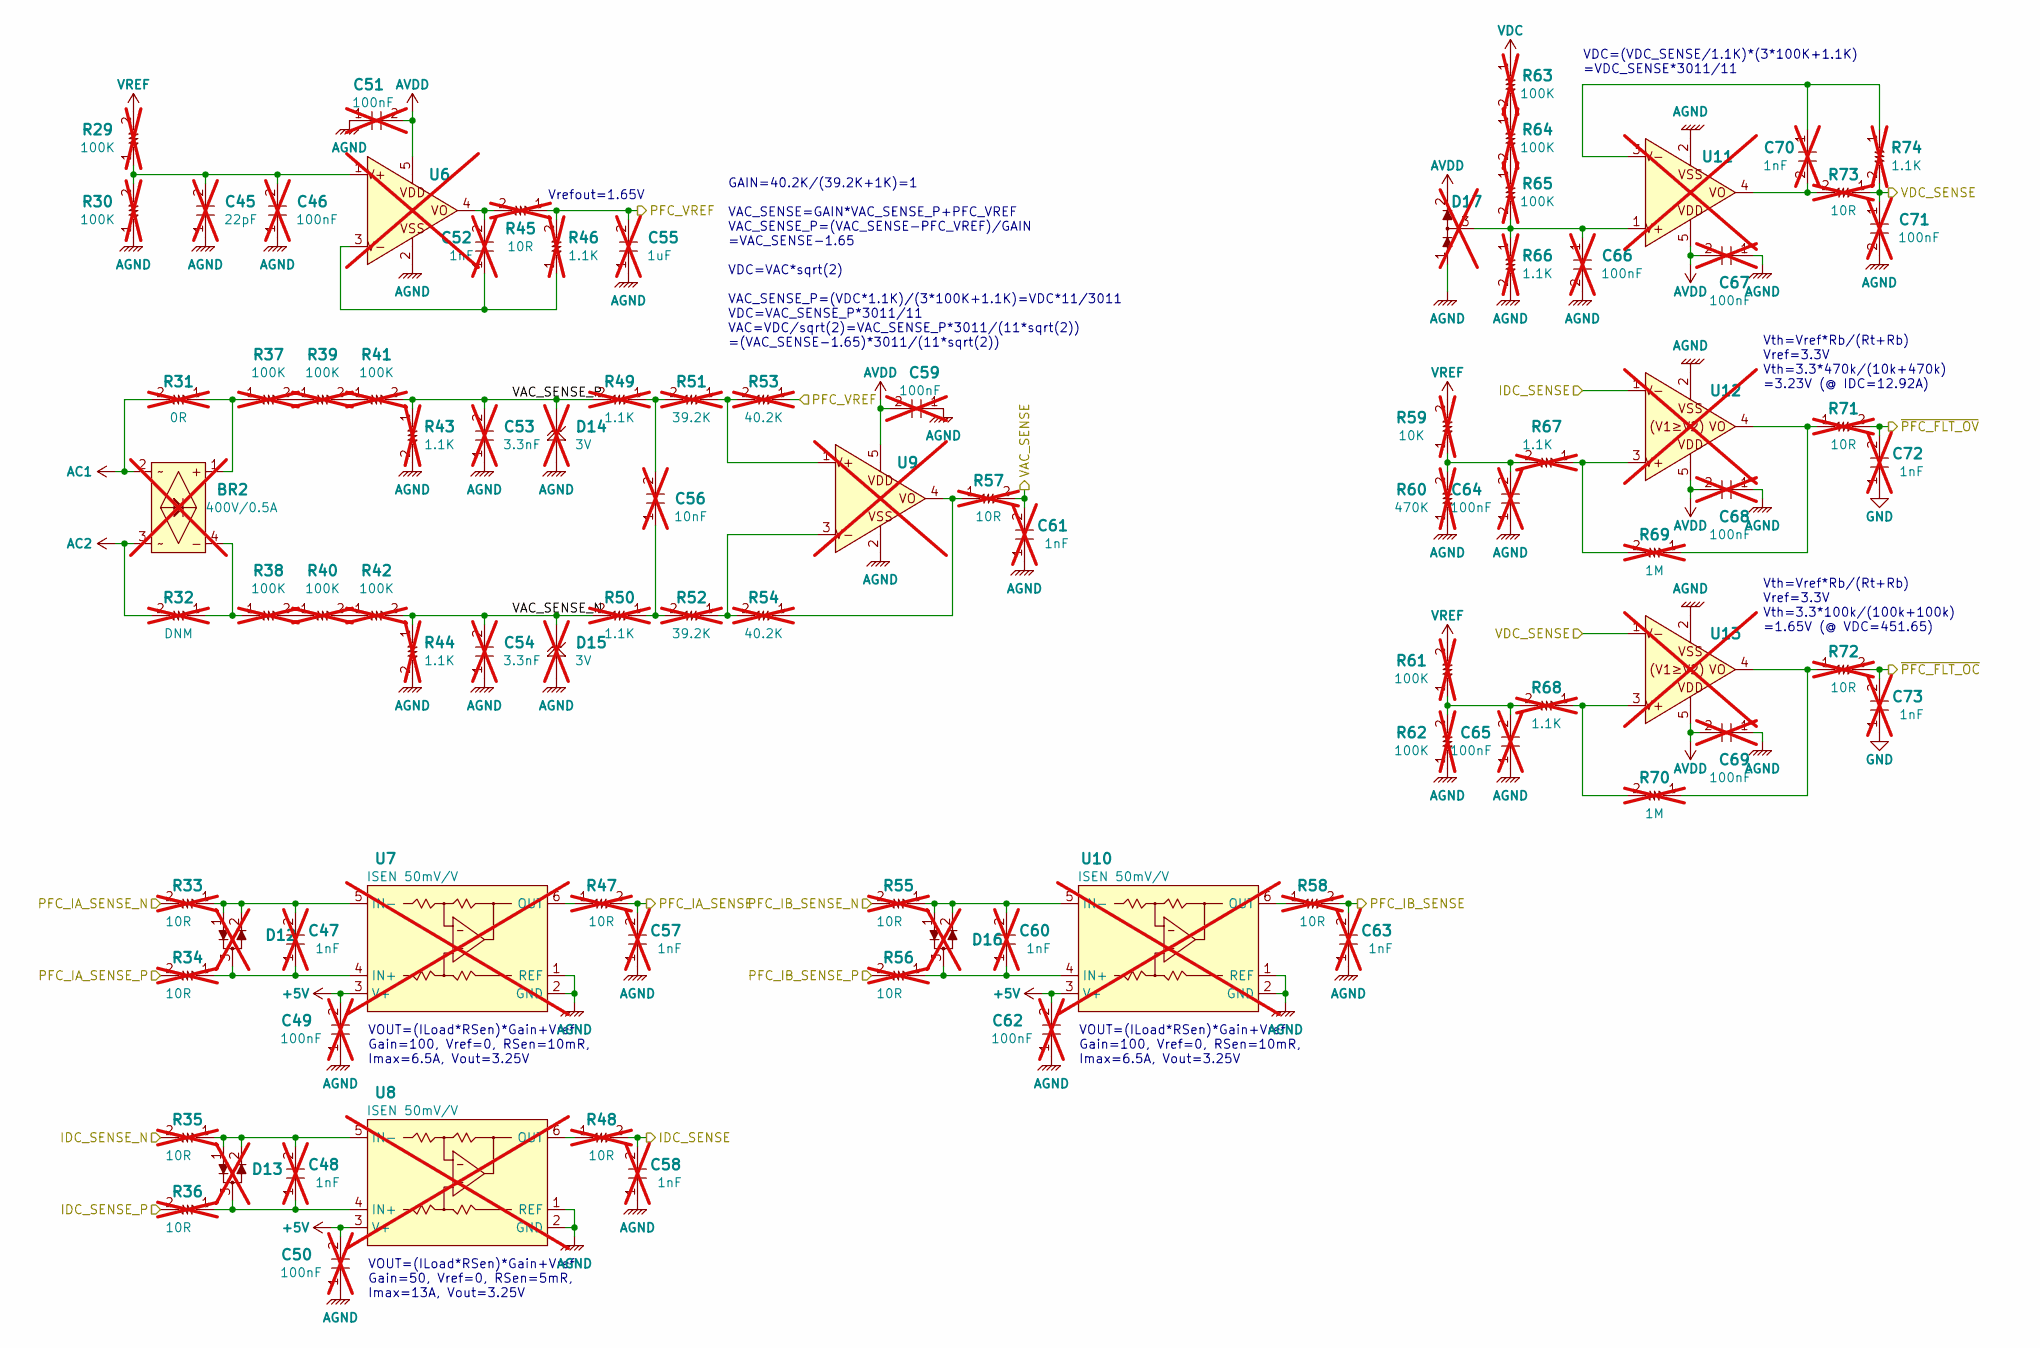
[picture p14: schematic VC_Measurement.kicad_sch]

Parts:
BR2: 400V/0.5A; MBF; not fitted
C45: 22pF; CAP0603; not fitted
C46, C49, C50, C51, C59, C62, C64, C65, C66, C67, C68, C69, C71: 100nF; CAP0603; not fitted
C47, C48, C52, C57, C58, C60, C61, C63, C70, C72, C73: 1nF; CAP0603; not fitted
C53, C54: 3.3nF; CAP0603; not fitted
C55: 1uF; CAP0603; not fitted
C56: 10nF; CAP0603; not fitted
D12, D13, D16, D17: GP DIODE; SOT23; not fitted
D14, D15: 3V; SOD-123; not fitted
R29, R30, R37, R38, R39, R40, R41, R42, R61, R62, R63, R64, R65: 100K; RES0603; not fitted
R31: 0R; RES0603; not fitted
R32: DNM; RES0603; not fitted
R33, R34, R35, R36, R45, R47, R48, R55, R56, R57, R58, R71, R72, R73: 10R; RES0603; not fitted
R43, R44, R46, R49, R50, R66, R67, R68, R74: 1.1K; RES0603; not fitted
R51, R52: 39.2K; RES0603; not fitted
R53, R54: 40.2K; RES0603; not fitted
R59: 10K; RES0603; not fitted
R60: 470K; RES0603; not fitted
R69, R70: 1M; RES1206; not fitted
U6, U9, U11: OP-1CH; SOT353; not fitted
U7, U8, U10: ISEN 50mV/V; SOT363; not fitted
U12, U13: CMP-1CH; SOT25_DIODES; not fitted

Connections:
+5V: C49.2, C50.2, C62.2, U7.3 (V+), U8.3 (V+), U10.3 (V+)
AC1: BR2.2 (AC1), R31.2
AC2: BR2.3 (AC2), R32.2
AGND: C45.1, C46.1, C49.1, C50.1, C51.1, C53.1, C54.1, C55.1, C57.1, C58.1, C59.1, C61.1, C62.1, C63.1, C64.1, C65.1, C66.2, C67.1, C68.1, C69.1, C71.2, D14.A, D15.A, D17.1 (A1), R30.1, R43.2, R44.2, R60.1, R62.1, R66.2, U6.2 (VSS), U7.1 (REF), U7.2 (GND), U8.1 (REF), U8.2 (GND), U9.2 (VSS), U10.1 (REF), U10.2 (GND), U11.2 (VSS), U12.2 (VSS), U13.2 (VSS)
AVDD: C51.2, C59.2, C67.2, C68.2, C69.2, D17.2 (K2), U6.5 (VDD), U9.5 (VDD), U11.5 (VDD), U12.5 (VDD), U13.5 (VDD)
GND: C72.1, C73.1
IDC_SENSE: C58.2, R48.2, U12.1 (VIN-)
IDC_SENSE_N: R35.2
IDC_SENSE_P: R36.2
unnamed: BR2.1 (DC+), R31.1, R37.1
unnamed: BR2.4 (DC-), R32.1, R38.1
unnamed: C45.2, C46.2, R29.1, R30.2, U6.1 (VIN+)
unnamed: C47.1, D12.3 (COM), R34.1, U7.4 (IN+)
unnamed: C47.2, D12.1 (A1), D12.2 (K2), R33.1, U7.5 (IN-)
unnamed: C48.1, D13.3 (COM), R36.1, U8.4 (IN+)
unnamed: C48.2, D13.1 (A1), D13.2 (K2), R35.1, U8.5 (IN-)
unnamed: C52.1, R46.1, U6.3 (VIN-)
unnamed: C52.2, R45.2, U6.4 (VOUT)
unnamed: C56.1, R50.1, R52.2
unnamed: C56.2, R49.1, R51.2
unnamed: C60.1, D16.3 (COM), R56.1, U10.4 (IN+)
unnamed: C60.2, D16.1 (A1), D16.2 (K2), R55.1, U10.5 (IN-)
unnamed: C64.2, R59.1, R60.2, R67.2
unnamed: C65.2, R61.1, R62.2, R68.2
unnamed: C66.1, D17.3 (COM), R65.2, R66.1, U11.1 (VIN+)
unnamed: C70.1, R74.1, U11.3 (VIN-)
unnamed: C70.2, R73.2, U11.4 (VOUT)
unnamed: R37.2, R39.1
unnamed: R38.2, R40.1
unnamed: R39.2, R41.1
unnamed: R40.2, R42.1
unnamed: R47.1, U7.6 (OUT)
unnamed: R48.1, U8.6 (OUT)
unnamed: R51.1, R53.2, U9.1 (VIN+)
unnamed: R52.1, R54.2, U9.3 (VIN-)
unnamed: R54.1, R57.1, U9.4 (VOUT)
unnamed: R58.1, U10.6 (OUT)
unnamed: R63.2, R64.1
unnamed: R64.2, R65.1
unnamed: R67.1, R69.2, U12.3 (VIN+)
unnamed: R68.1, R70.2, U13.3 (VIN+)
unnamed: R69.1, R71.1, U12.4 (VOUT)
unnamed: R70.1, R72.1, U13.4 (VOUT)
PFC_IA_SENSE: C57.2, R47.2
PFC_IA_SENSE_N: R33.2
PFC_IA_SENSE_P: R34.2
PFC_IB_SENSE: C63.2, R58.2
PFC_IB_SENSE_N: R55.2
PFC_IB_SENSE_P: R56.2
PFC_VREF: C55.2, R45.1, R46.2, R53.1
VAC_SENSE: C61.2, R57.2
VAC_SENSE_N: C54.2, D15.K, R42.2, R44.1, R50.2
VAC_SENSE_P: C53.2, D14.K, R41.2, R43.1, R49.2
VDC: R63.1
VDC_SENSE: C71.1, R73.1, R74.2, U13.1 (VIN-)
VREF: R29.2, R59.2, R61.2
~PFC_FLT_OC: C73.2, R72.2
~PFC_FLT_OV: C72.2, R71.2

Notes on the sheet:
Vth=Vref*Rb/(Rt+Rb) Vref=3.3V Vth=3.3*470k/(10k+470k) =3.23V (@ IDC=12.92A)
Vth=Vref*Rb/(Rt+Rb) Vref=3.3V Vth=3.3*100k/(100k+100k) =1.65V (@ VDC=451.65)
Vrefout=1.65V
VOUT=(ILoad*RSen)*Gain+Vref Gain=100, Vref=0, RSen=10mR, Imax=6.5A, Vout=3.25V
VDC=(VDC_SENSE/1.1K)*(3*100K+1.1K) =VDC_SENSE*3011/11
GAIN=40.2K/(39.2K+1K)=1 VAC_SENSE=GAIN*VAC_SENSE_P+PFC_VREF VAC_SENSE_P=(VAC_SENSE-PFC_VREF)/GAIN =VAC_SENSE-1.65 VDC=VAC*sqrt(2) VAC_SENSE_P=(VDC*1.1K)/(3*100K+1.1K)=VDC*11/3011 VDC=VAC_SENSE_P*3011/11 VAC=VDC/sqrt(2)=VAC_SENSE_P*3011/(11*sqrt(2)) =(VAC_SENSE-1.65)*3011/(11*sqrt(2))
VOUT=(ILoad*RSen)*Gain+Vref Gain=50, Vref=0, RSen=5mR, Imax=13A, Vout=3.25V
