sampidevkit/ACIM-PowerSupply/(commit log)

2024-09-25 V0 production files
    [HW.ACIM-PSU-B_Cu.gbr, HW.ACIM-PSU-B_Mask.gbr, HW.ACIM-PSU-B_Paste.gbr, HW.ACIM-PSU-B_Silkscreen.gbr, HW.ACIM-PSU-Edge_Cuts.gbr, HW.ACIM-PSU-F_Cu.gbr, HW.ACIM-PSU-F_Mask.gbr, HW.ACIM-PSU-F_Paste.gbr]
2024-09-26 V0 production files update 1
    [Interleaved_PFC.kicad_sch, MCU.kicad_sch, VC_Measurement.kicad_sch]
2024-10-10 V0 production files update 2
    [Interleaved_PFC.kicad_sch, MCU.kicad_sch, Power_Supply.kicad_sch, VC_Measurement.kicad_sch]
